RTSYork/UltrasoundRobot/robot_diagrams/robot.png

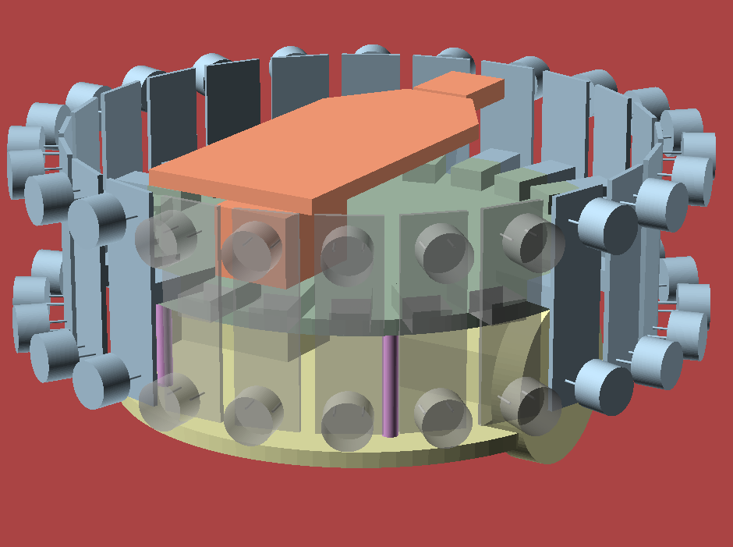
robot_diagrams/robot.png
