RTSYork/UltrasoundRobot/README.md

Ultrasonic Array for Maze Robot
----
Phil Greenland and Russell Joyce  
Department of Computer Science, University of York, UK

---

For more information, see http://rtslab.wikispaces.com/Ultrasonic+Array+for+Maze+Robot
