RTSYork/UltrasoundRobot/maze_diagrams/maze.png

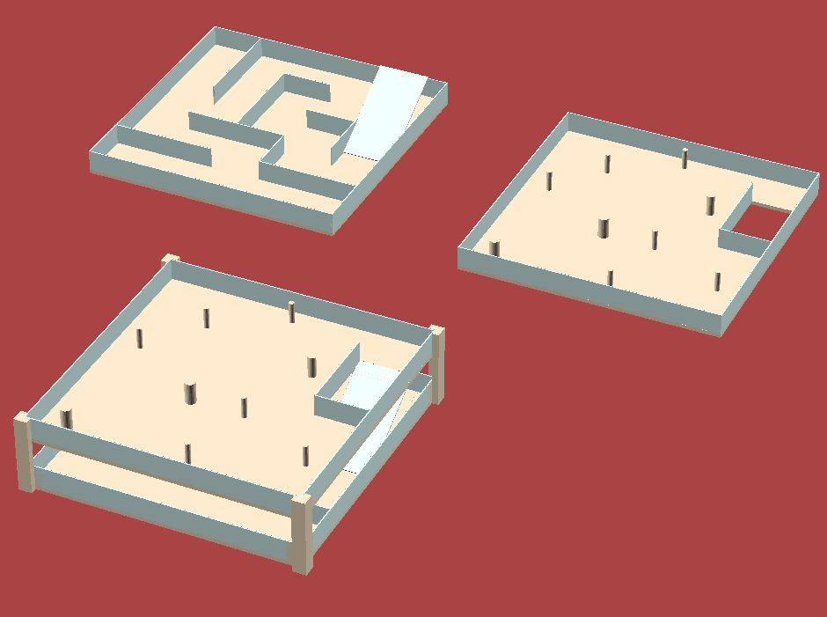
maze_diagrams/maze.png
