RTSYork/UltrasoundRobot/(list of files, cad)

Other CAD files:
cad_diagrams/placement_diagram.dwg
