RTSYork/UltrasoundRobot/ultrasound_fpga/Ultrasound/pcores/pulsegen_v1_00_a/devl/projnav/par_usage_statistics.html

Par Statistics

Total Non-vccgnd Signals=167

Total Non-vccgnd Design Pins=498

Total Non-vccgnd Conns=498

Total Non-vccgnd Timing Constrained Conns=414

Phase 1 CPU=3.7 sec

Phase 2 CPU=3.9 sec

Phase 3 CPU=4.3 sec

Phase 4 CPU=4.9 sec

Phase 5 CPU=5.1 sec

Phase 6 CPU=5.1 sec

Phase 7 CPU=5.1 sec

Phase 8 CPU=5.1 sec

Phase 9 CPU=5.1 sec

Phase 10 CPU=5.2 sec

AvgWirelenPerPin Fanout 1=13.0

AvgWirelenPerPin Fanout 2=5.5

AvgWirelenPerPin Fanout 3=14.0

AvgWirelenPerPin Fanout 4=6.8

AvgWirelenPerPin Fanout 10=3.6

AvgWirelenPerPin Fanout 50=3.3

AvgWirelenPerPin Fanout 100=0.0

AvgWirelenPerPin Fanout 500=0.0

AvgWirelenPerPin Fanout 5000=0.0

AvgWirelenPerPin Fanout 20000=0.0

AvgWirelenPerPin Fanout 50000=0.0

AvgWirelenPerPin Fanout 100000=0.0

IRR Gamma=1.0363
