RTSYork/UltrasoundRobot/eagle/ultrasound/Sensor.brd

## EAGLE design eagle/ultrasound/Sensor.brd (2013-08-06)

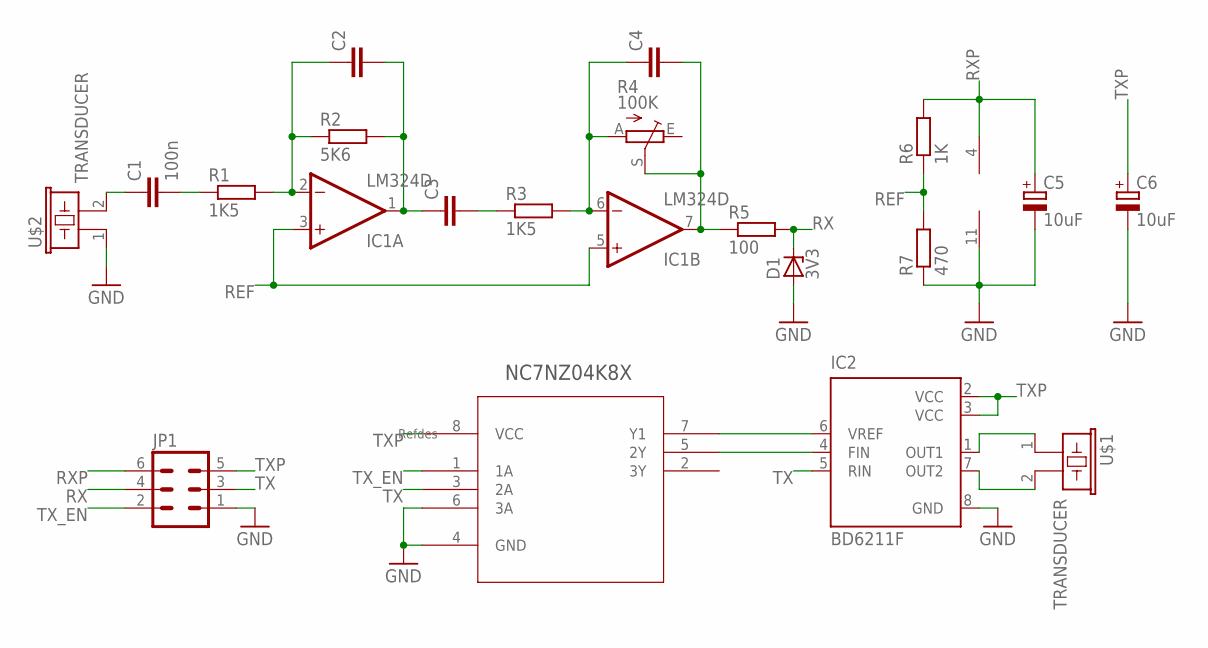
[picture p3: schematic Sensor.sch]

Parts:
C1: 100n; C0805
C2, C3, C4: C-EUC0805; C0805
C5, C6: 10uF; E2-5
D1: 3V3; ZDIO-2.5
IC1: LM324D; SO14
IC2: BD6211F; SOP8
JP1: MA03-2
R1, R3: 1K5; R0805
R2: 5K6; R0805
R4: 100K; S63P
R5: 100; R0805
R6: 1K; R0805
R7: 470; R0805
U1: NC7NZ04K8X; SOP50P310X90-8N
U$1, U$2: TRANSDUCER

Connections:
GND: C5.-, C6.-, D1.A, IC1.11 (V-), IC2.8 (GND), JP1.1, R7.1, U1.4 (GND), U1.6 (3A), U$2.1
unnamed: C2.1, IC1.2 (-IN), R1.2, R2.1
unnamed: C1.2, R1.1
unnamed: C2.2, C3.1, IC1.1 (OUT), R2.2
unnamed: C3.2, R3.1
unnamed: C4.1, IC1.6 (-IN), R3.2, R4.A
unnamed: C4.2, IC1.7 (OUT), R4.S, R5.1
unnamed: C1.1, U$2.2
unnamed: IC2.1 (OUT1), U$1.1
unnamed: IC2.7 (OUT2), U$1.2
unnamed: IC2.6 (VREF), U1.7 (Y1)
unnamed: IC2.4 (FIN), U1.5 (2Y)
REF: IC1.3 (+IN), IC1.5 (+IN), R6.1, R7.2
RX: D1.C, JP1.4, R5.2
RXP: C5.+, IC1.4 (V+), JP1.6, R6.2
TX: IC2.5 (RIN), JP1.3, U1.3 (2A)
TXP: C6.+, IC2.2 (VCC), IC2.3 (VCC), JP1.5, U1.8 (VCC)
TX_EN: JP1.2, U1.1 (1A)

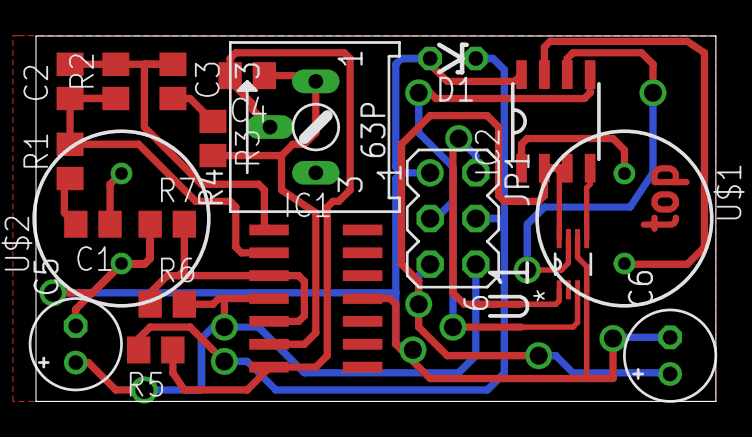
[picture p4: board Sensor.brd from above]

Board: 2 copper layers, 37.8 x 20.3 mm, 20 parts (0 on the bottom side), 18 nets.
