RTSYork/UltrasoundRobot/eagle/ultrasound/Mainboard.brd

## EAGLE design eagle/ultrasound/Mainboard.brd (2013-04-26)

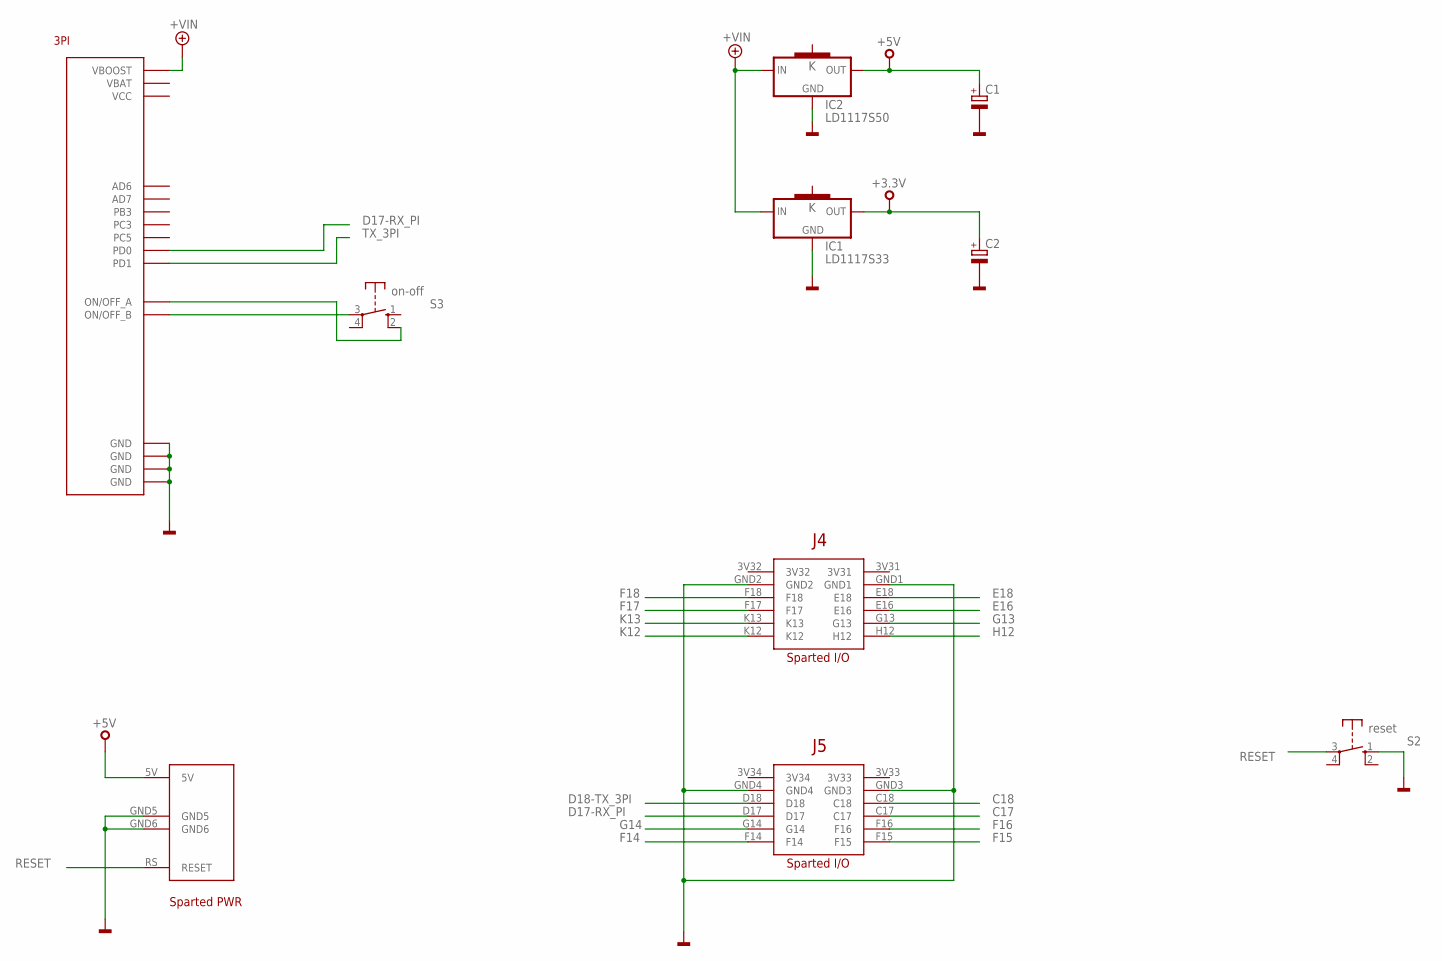
[picture p5: schematic Mainboard.sch, sheet 1]

Parts:
C1, C2: CPOL-EUE2.5-5; E2,5-5
IC1: LD1117S33; SOT223
IC2: LD1117S50; SOT223
S2: reset; DT6
S3: on-off; DT6
U$1: M3PI-NO-LCD
U$4: LX9

Connections:
+3,3V: C2.+, IC1.2 (OUT)
+5V: C1.+, IC2.2 (OUT), U$4.5V; also elsewhere on the board
+VIN: IC1.3 (IN), IC2.3 (IN), U$1.VBOOST
C17: U$4.C17; also elsewhere on the board
C18: U$4.C18; also elsewhere on the board
D17-RX_PI: U$1.PD0, U$4.D17
D18-TX_3PI: U$4.D18; also elsewhere on the board
E16: U$4.E16; also elsewhere on the board
E18: U$4.E18; also elsewhere on the board
F14: U$4.F14; also elsewhere on the board
F15: U$4.F15; also elsewhere on the board
F16: U$4.F16; also elsewhere on the board
F17: U$4.F17; also elsewhere on the board
F18: U$4.F18; also elsewhere on the board
G13: U$4.G13; also elsewhere on the board
G14: U$4.G14; also elsewhere on the board
GND: C1.-, C2.-, IC1.1 (GND), IC2.1 (GND), S2.1 (S), U$1.GND@1 (GND), U$1.GND@2 (GND), U$1.GND@3 (GND), U$1.GND@4 (GND), U$4.GND1, U$4.GND2, U$4.GND3, U$4.GND4, U$4.GND5, U$4.GND6; also elsewhere on the board
H12: U$4.H12; also elsewhere on the board
K12: U$4.K12; also elsewhere on the board
K13: U$4.K13; also elsewhere on the board
unnamed: S3.3, U$1.ON/OFF_B
unnamed: S3.2 (S), U$1.ON/OFF_A
RESET: S2.3, U$4.RS (RESET)
TX_3PI: U$1.PD1; also elsewhere on the board

Notes on the sheet:
Sparted I/O
Sparted PWR

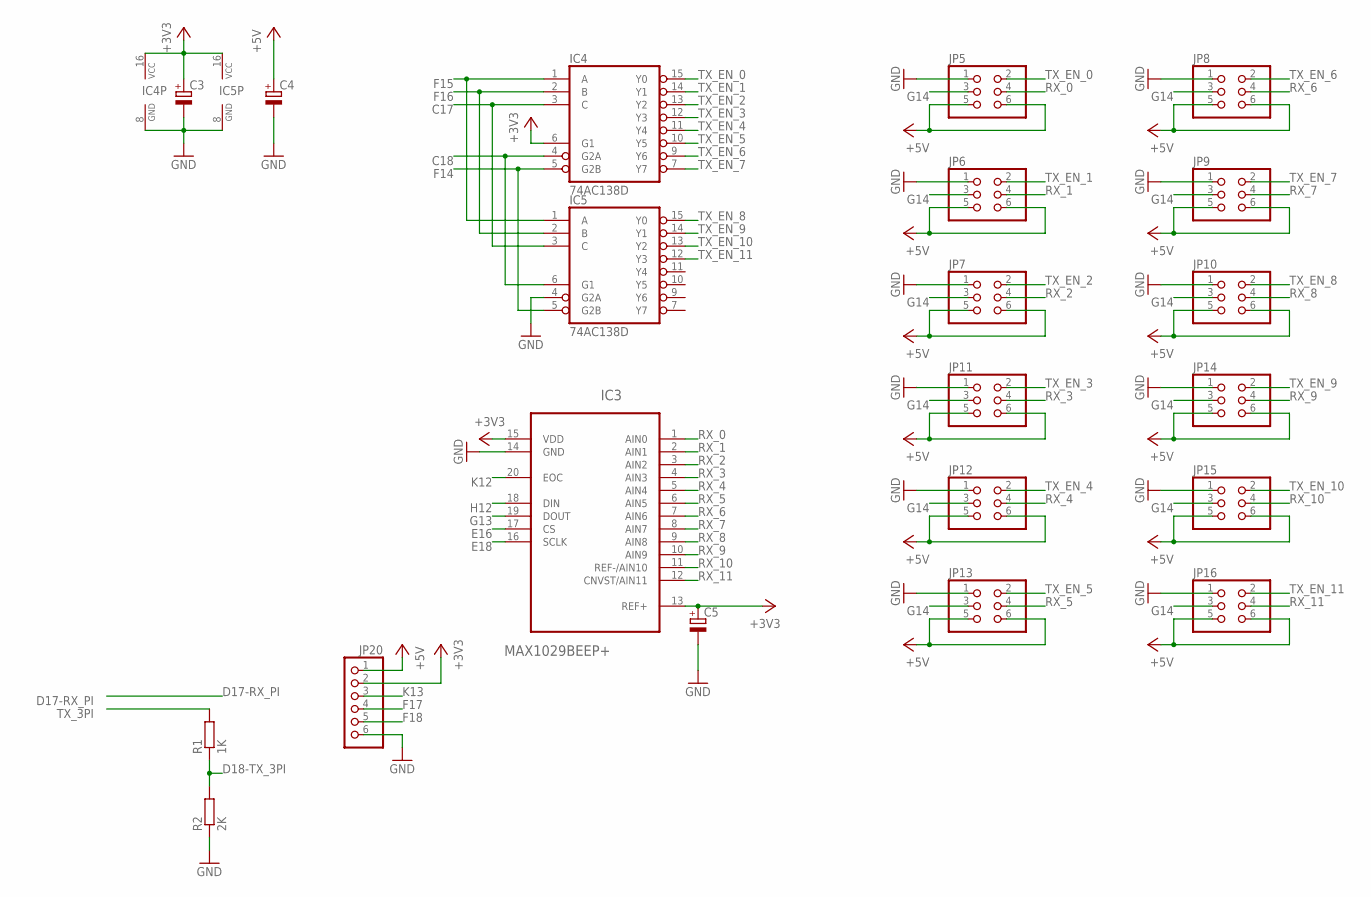
[picture p6: schematic Mainboard.sch, sheet 2]

Parts:
C3, C4, C5: CPOL-EUE2-5; E2-5
IC3: MAX1029BEEP+; SOP64P600X165-20N
IC4, IC5: 74AC138D; SO16
JP5, JP9: PINHD-2X3; 2X03
JP6, JP7, JP8, JP10, JP11, JP12, JP13, JP14, JP15, JP16: PINHD-2X3/90; 2X03/90
JP20: PINHD-1X6; 1X06
R1: 1K; R0805
R2: 2K; R0805

Connections:
+3V3: C3.+, C5.+, IC3.13 (REF+), IC3.15 (VDD), IC4.6 (G1), IC4.16 (VCC), IC5.16 (VCC), JP20.2
+5V: C4.+, JP5.5, JP5.6, JP6.5, JP6.6, JP7.5, JP7.6, JP8.5, JP8.6, JP9.5, JP9.6, JP10.5, JP10.6, JP11.5, JP11.6, JP12.5, JP12.6, JP13.5, JP13.6, JP14.5, JP14.6, JP15.5, JP15.6, JP16.5, JP16.6, JP20.1; also elsewhere on the board
C17: IC4.3 (C), IC5.3 (C); also elsewhere on the board
C18: IC4.4 (G2A), IC5.6 (G1); also elsewhere on the board
D18-TX_3PI: R1.1, R2.2; also elsewhere on the board
E16: IC3.17 (CS); also elsewhere on the board
E18: IC3.16 (SCLK); also elsewhere on the board
F14: IC4.5 (G2B), IC5.5 (G2B); also elsewhere on the board
F15: IC4.1 (A), IC5.1 (A); also elsewhere on the board
F16: IC4.2 (B), IC5.2 (B); also elsewhere on the board
F17: JP20.4; also elsewhere on the board
F18: JP20.5; also elsewhere on the board
G13: IC3.19 (DOUT); also elsewhere on the board
G14: JP5.3, JP6.3, JP7.3, JP8.3, JP9.3, JP10.3, JP11.3, JP12.3, JP13.3, JP14.3, JP15.3, JP16.3; also elsewhere on the board
GND: C3.-, C4.-, C5.-, IC3.14 (GND), IC4.8 (GND), IC5.4 (G2A), IC5.8 (GND), JP5.1, JP6.1, JP7.1, JP8.1, JP9.1, JP10.1, JP11.1, JP12.1, JP13.1, JP14.1, JP15.1, JP16.1, JP20.6, R2.1; also elsewhere on the board
H12: IC3.18 (DIN); also elsewhere on the board
K12: IC3.20 (EOC); also elsewhere on the board
K13: JP20.3; also elsewhere on the board
RX_0: IC3.1 (AIN0), JP5.4
RX_1: IC3.2 (AIN1), JP6.4
RX_2: IC3.3 (AIN2), JP7.4
RX_3: IC3.4 (AIN3), JP11.4
RX_4: IC3.5 (AIN4), JP12.4
RX_5: IC3.6 (AIN5), JP13.4
RX_6: IC3.7 (AIN6), JP8.4
RX_7: IC3.8 (AIN7), JP9.4
RX_8: IC3.9 (AIN8), JP10.4
RX_9: IC3.10 (AIN9), JP14.4
RX_10: IC3.11 (REF-/AIN10), JP15.4
RX_11: IC3.12 (CNVST/AIN11), JP16.4
TX_3PI: R1.2; also elsewhere on the board
TX_EN_0: IC4.15 (Y0), JP5.2
TX_EN_1: IC4.14 (Y1), JP6.2
TX_EN_2: IC4.13 (Y2), JP7.2
TX_EN_3: IC4.12 (Y3), JP11.2
TX_EN_4: IC4.11 (Y4), JP12.2
TX_EN_5: IC4.10 (Y5), JP13.2
TX_EN_6: IC4.9 (Y6), JP8.2
TX_EN_7: IC4.7 (Y7), JP9.2
TX_EN_8: IC5.15 (Y0), JP10.2
TX_EN_9: IC5.14 (Y1), JP14.2
TX_EN_10: IC5.13 (Y2), JP15.2
TX_EN_11: IC5.12 (Y3), JP16.2

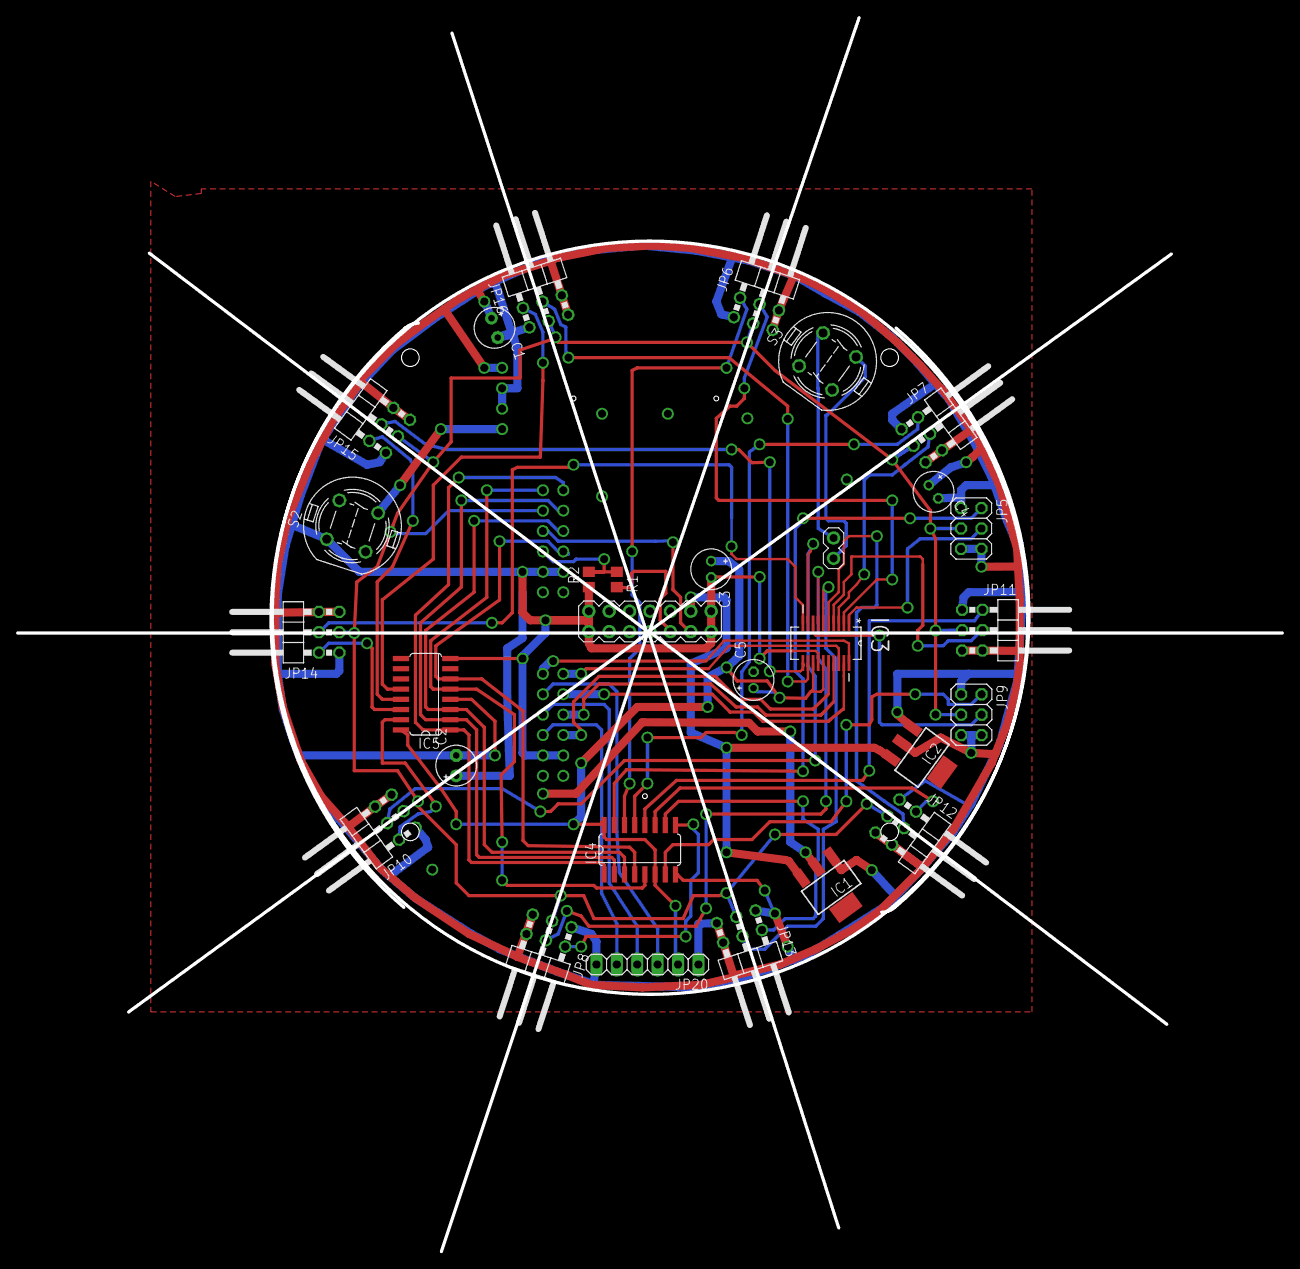
[picture p7: board eagle/ultrasound/Mainboard.brd from above]

Board: 2 copper layers, 157.5 x 153.7 mm, 29 parts (1 on the bottom side), 49 nets.
