RTSYork/UltrasoundRobot/eagle/fpga-3pi/FPGA-m3pi.brd

## EAGLE design eagle/fpga-3pi/FPGA-m3pi.brd (2013-04-26)

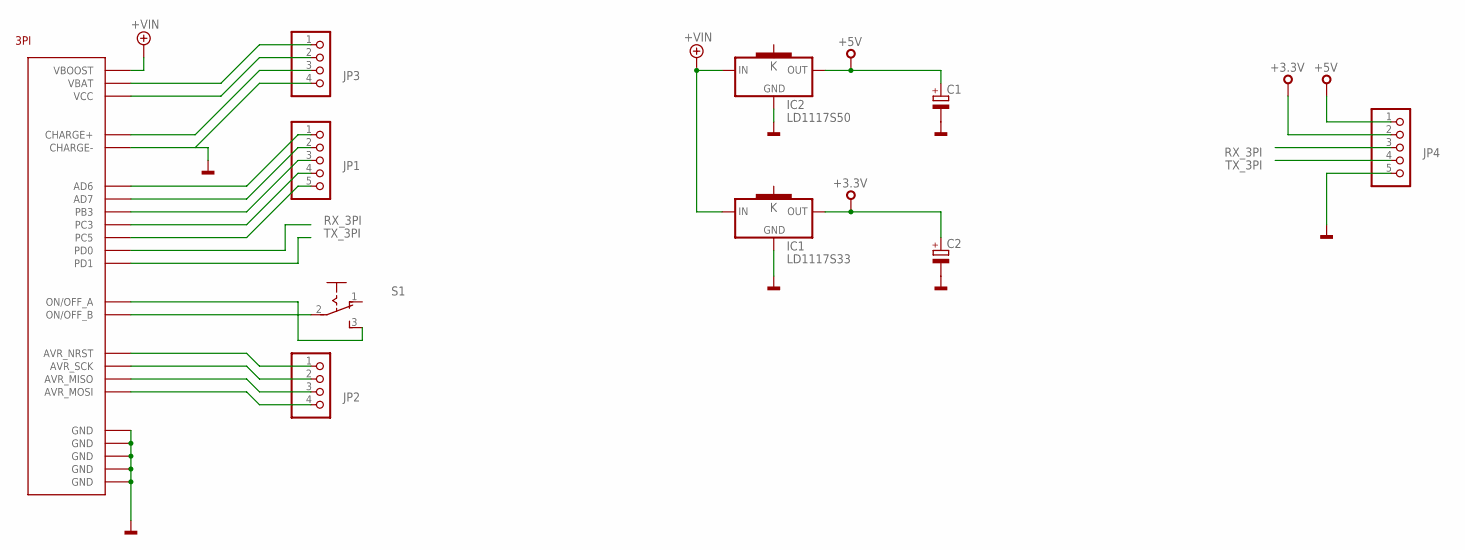
[picture p8: schematic FPGA-m3pi.sch]

Parts:
C1, C2: CPOL-EUE2.5-5; E2,5-5
IC1: LD1117S33; SOT223
IC2: LD1117S50; SOT223
JP1, JP4: PINHD-1X5; 1X05
JP2, JP3: PINHD-1X4; 1X04
S1: M251
U$1: MBED-M3PI_3PI

Connections:
+3,3V: C2.+, IC1.2 (OUT), JP4.2
+5V: C1.+, IC2.2 (OUT), JP4.1
+VIN: IC1.3 (IN), IC2.3 (IN), U$1.VBOOST
GND: C1.-, C2.-, IC1.1 (GND), IC2.1 (GND), JP3.4, JP4.5, U$1.CHARGE-, U$1.GND@1 (GND), U$1.GND@2 (GND), U$1.GND@3 (GND), U$1.GND@4 (GND), U$1.GND@5 (GND)
unnamed: JP1.1, U$1.AD6
unnamed: JP1.2, U$1.AD7
unnamed: S1.2, U$1.ON/OFF_B
unnamed: S1.3 (S), U$1.ON/OFF_A
unnamed: JP1.3, U$1.PB3
unnamed: JP1.4, U$1.PC3
unnamed: JP1.5, U$1.PC5
unnamed: JP2.1, U$1.AVR_NRST
unnamed: JP2.2, U$1.AVR_SCK
unnamed: JP2.3, U$1.AVR_MISO
unnamed: JP2.4, U$1.AVR_MOSI
unnamed: JP3.3, U$1.CHARGE+
unnamed: JP3.2, U$1.VCC
unnamed: JP3.1, U$1.VBAT
RX_3PI: JP4.3, U$1.PD0
TX_3PI: JP4.4, U$1.PD1

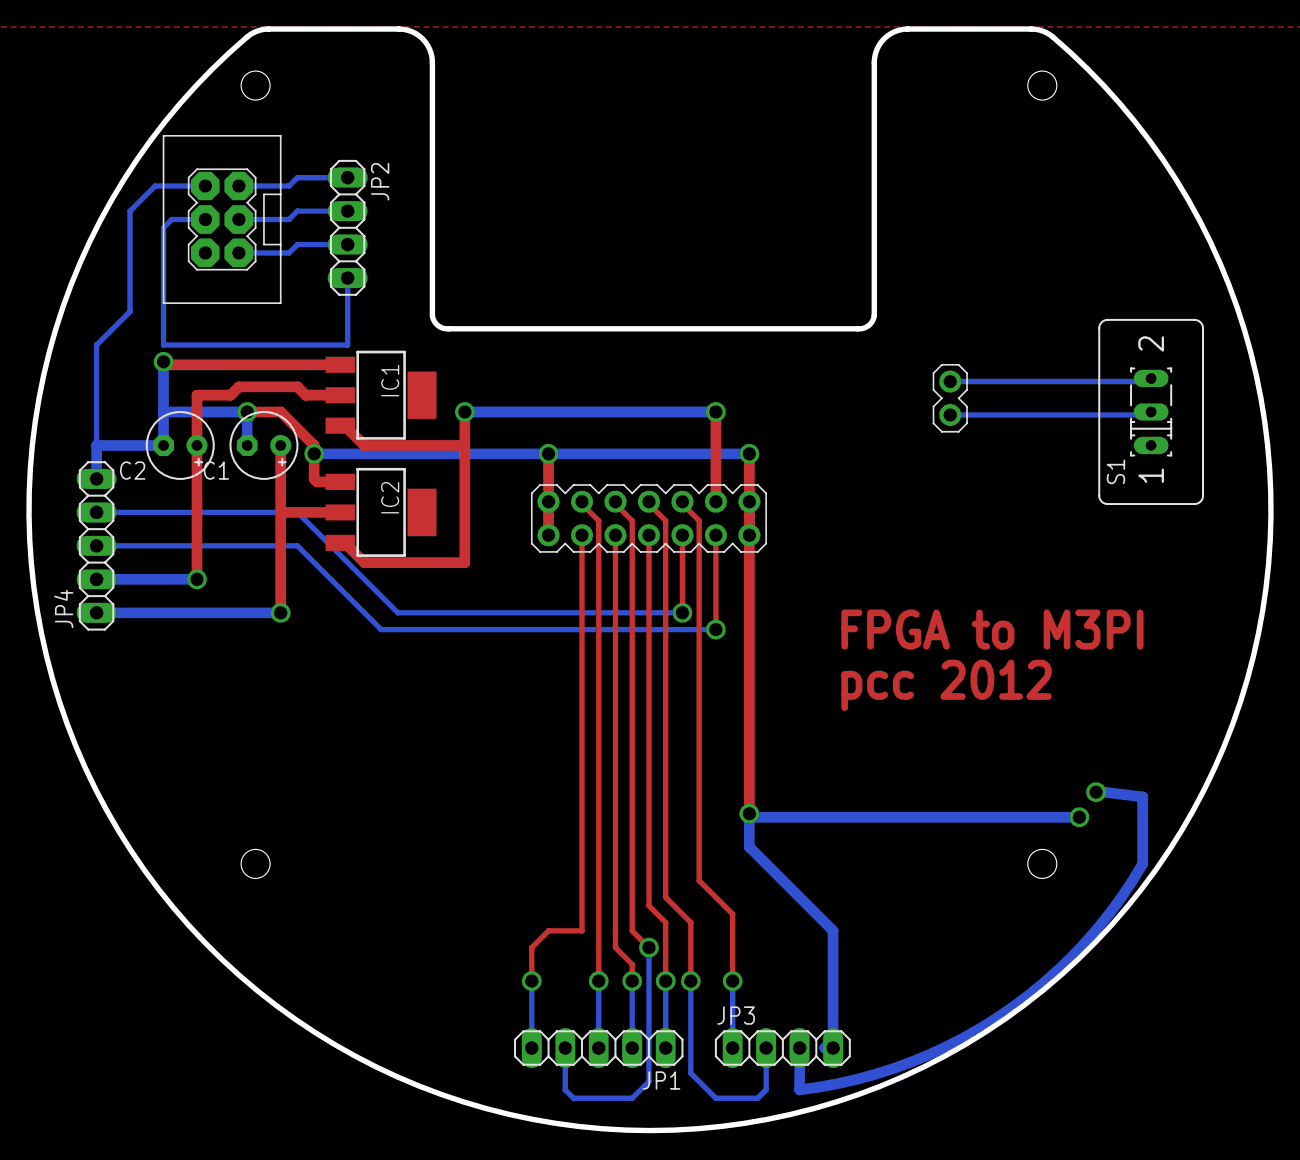
[picture p9: board FPGA-m3pi.brd from above]

Board: 2 copper layers, 94.2 x 83.6 mm, 10 parts (0 on the bottom side), 20 nets.
