RTSYork/UltrasoundRobot/eagle/prototype/Mainboard.brd

## EAGLE design eagle/prototype/Mainboard.brd (2013-04-26)

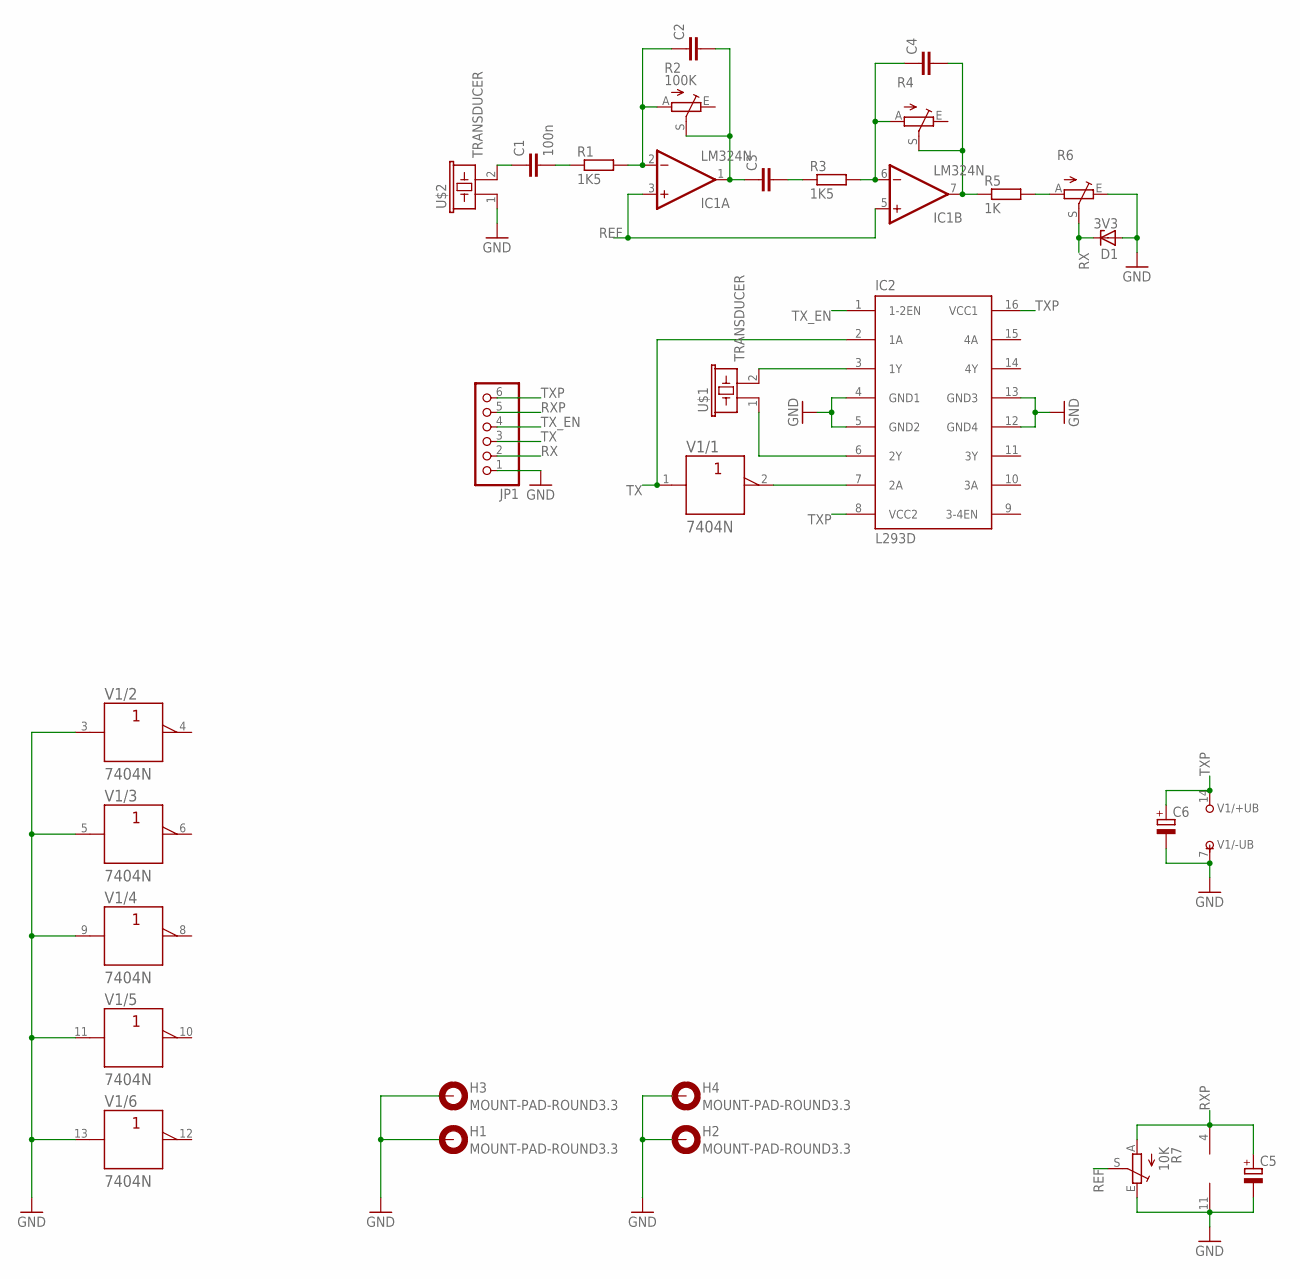
[picture p10: schematic Mainboard.sch]

Parts:
C1: 100n; C025-025X050
C2, C3, C4: C-EU025-025X050; C025-025X050
C5, C6: CPOL-EUE2-5; E2-5
D1: 3V3; ZDIO-2.5
H1, H2, H3, H4: MOUNT-PAD-ROUND3.3; 3,3-PAD
IC1: LM324N; DIL14
IC2: L293D; DIL16
JP1: PINHD-1X6; 1X06
R1, R3: 1K5; 0207/2V
R2: 100K; S63P
R4, R6: TRIM_EU-S63P; S63P
R5: 1K; 0207/2V
R7: 10K; S63P
U$1, U$2: TRANSDUCER
V1: 7404N; DIL14

Connections:
GND: C5.-, C6.-, D1.A, H1.B3,3, H2.B3,3, H3.B3,3, H4.B3,3, IC1.11 (V-), IC2.4 (GND1), IC2.5 (GND2), IC2.12 (GND4), IC2.13 (GND3), JP1.1, R6.E, R7.E, U$2.1, V1.3 (A), V1.5 (A), V1.7 (-UB), V1.9 (A), V1.11 (A), V1.13 (A)
unnamed: C2.1, IC1.2 (-IN), R1.2, R2.A
unnamed: C1.2, R1.1
unnamed: C2.2, C3.1, IC1.1 (OUT), R2.S
unnamed: R5.2, R6.A
unnamed: C3.2, R3.1
unnamed: C4.1, IC1.6 (-IN), R3.2, R4.A
unnamed: C4.2, IC1.7 (OUT), R4.S, R5.1
unnamed: IC2.7 (2A), V1.2 (Y)
unnamed: C1.1, U$2.2
unnamed: IC2.3 (1Y), U$1.2
unnamed: IC2.6 (2Y), U$1.1
REF: IC1.3 (+IN), IC1.5 (+IN), R7.S
RX: D1.C, JP1.2, R6.S
RXP: C5.+, IC1.4 (V+), JP1.5, R7.A
TX: IC2.2 (1A), JP1.3, V1.1 (A)
TXP: C6.+, IC2.8 (VCC2), IC2.16 (VCC1), JP1.6, V1.14 (+UB)
TX_EN: IC2.1 (1-2EN), JP1.4

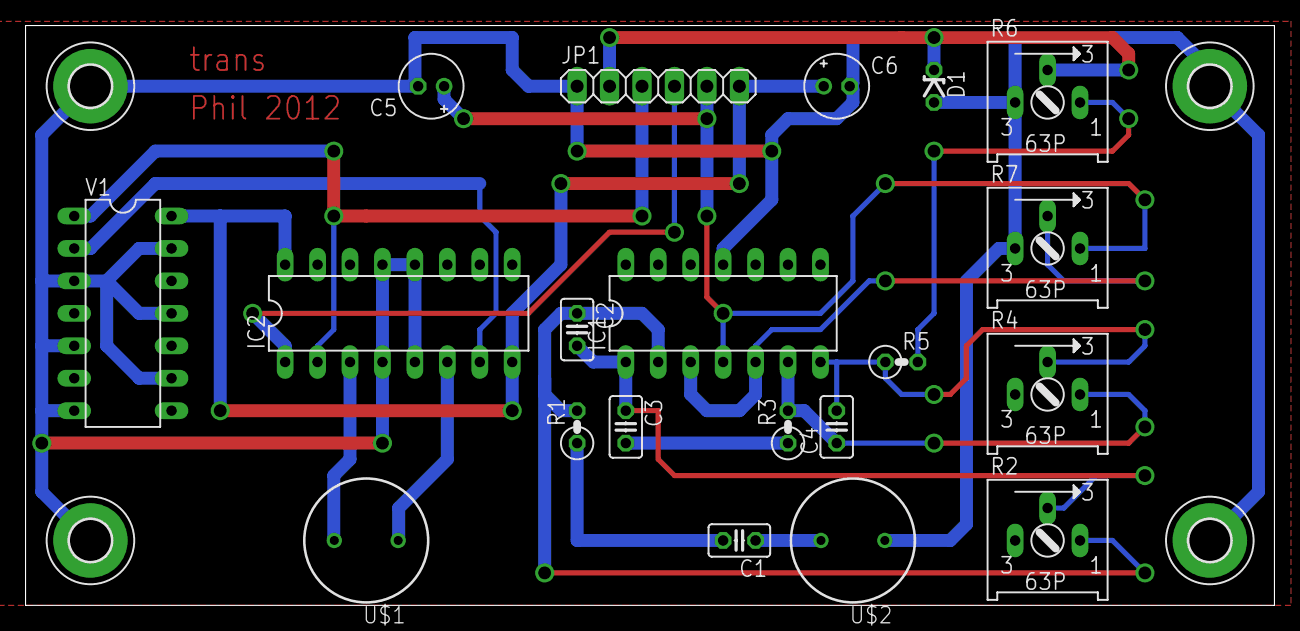
[picture p11: board eagle/prototype/Mainboard.brd from above]

Board: 2 copper layers, 97.8 x 45.4 mm, 24 parts (0 on the bottom side), 18 nets.
