RTSYork/UltrasoundRobot/ultrasound_fpga/workspace/ultrasound/src/usarray.h

#ifndef USARRAY_H_
#define USARRAY_H_

#include "xil_types.h"

#define US_SENSOR_COUNT 10 // Number of sensors installed on platform
#define US_SENSOR_MAP {9, 10, 11, 1, 2, 3, 4, 5, 6, 8} //Map sensor positions to sensor addresses
#define US_SAMPLE_RATE 80000 // Hz
#define US_RX_COUNT 200 // Number of waveform samples to take at US_SAMPLE_RATE in a single ranging operation
#define US_TX_COUNT 8 // Cycles of 40Khz ultrasound to transmit

#define USADCPrecision 10 // Bits
#define USADCReference 330 // Volts - expressed in hundredths

#define TRIGGER_NEAR_FAR_CHANGE 900 //  Time at which far trigger is used instead of near trigger
#define TRIGGER_BASE 160 // Default trigger voltage for distance detection (V*100)
#define TRIGGER_OFFSET_NEAR 41 // Default amount near trigger is away from base value
#define TRIGGER_OFFSET_FAR 11 // Default amount far trigger is away from base value

// Sensor locations
enum SENSOR_POSITION {
	SENSOR_FRONT_RIGHT = 8,
	SENSOR_RIGHT_FRONT = 9,
	SENSOR_RIGHT_MID   = 0,
	SENSOR_RIGHT_REAR  = 1,
	SENSOR_REAR_RIGHT  = 2,
	SENSOR_REAR_LEFT   = 3,
	SENSOR_LEFT_REAR   = 4,
	SENSOR_LEFT_MID    = 5,
	SENSOR_LEFT_FRONT  = 6,
	SENSOR_FRONT_LEFT  = 7
};

extern unsigned short usWaveformData[US_SENSOR_COUNT][US_RX_COUNT]; // Provide external access to sample results
extern signed short usRangeReadings[US_SENSOR_COUNT]; // Provide external access to range readings

int init_usarray();

void usarray_set_sensor(unsigned char newSensor);
unsigned char usarray_get_sensor();

void usarray_set_triggers(unsigned short changever, unsigned short nearLower, unsigned short nearUpper, unsigned short farLower, unsigned short farUpper);

short usarray_get_temperature();

void usarray_measure_temp();
void usarray_scan(u8 sensors[], u8 numSensors);
void usarray_update_ranges(u8 sensors[], u8 numSensors);

u16 usarray_distance(u8 sensor);
u8 usarray_detect_obstacle(u8 sensor, u16 distance);

#endif /* USARRAY_H_ */
