RTSYork/UltrasoundRobot/(commit log)

2013-04-19 Added 3D printed wheels and encoder template
    [3piwheelv1.scad, 3piwheelv2.scad, hole_test.scad]
2013-04-19 Added CAD diagrams
    [placement_diagram.dwg]
2013-04-19 Added maze diagrams
    [Maze.scad]
2013-04-19 Added ultrasound code for arduino and mbed, with processing code
2013-04-26 Added eagle diagrams
    [Darlington TX.sch, FPGA-m3pi.brd, FPGA-m3pi.sch, HBridge TX.sch, Mainboard.brd, Mainboard.sch, Sensor.brd, Sensor.sch]
2013-04-27 Renamed report eagle schematics to match figures.
    [darlington_ustx.sch, hbridge_ustx.sch]
2013-04-28 Continued design and implementation adding receiver amp and filters.
    [invert_amp_filters.sch, opamp_usrx.sch]
2013-04-29 Continued design and implementation.
    [invert_amp_filters.sch, opamp_usrx.sch]
2013-04-29 Removed pot from blueboard schematic.
    [opamp_usrx.sch]
2013-05-01 Continued design and implementation, completing all range finder diagrams.
    [Sensor.brd, Sensor.sch, mainboard.sch]
2013-05-02 Updated component values on daughter board schematic to match actual board.
    [Sensor.brd, Sensor.sch]
2013-05-02 Added positioning system to design and implementation.
    [pos_sys.sch]
2013-05-04 Added 3D robot diagram :-).
    [Robot.scad]
2013-05-04 Increased daughter board count to 28 and decreased width.
    [Robot.scad]
2013-05-04 Added 3D robot diagram to report.
    [Robot.scad]
2013-05-05 Compacted diagrams and headings. Changed word count format. Updated report page plan. Remoed mobile platform from design. Added placeholder software flow diagrams.
    [invert_amp_filters.sch, opamp_usrx.sch]
2013-05-09 Added temperature compensation to processing app, fixed trigger levels.
2013-05-18 Tweaked various bits of design and implementation. Reduced font size on all diagrams and adjusted diagrams accordingly.
    [darlington_ustx.sch]
2013-05-20 Bug fixes and tweaks to 3pi software.
    [ultrasound_3pi.ino]
2013-05-20 Bug fixes and additional features for ultrasound_fpga.
    [uart.c, uart.h, ultrasound.c, usarray.c, usarray.h]
2013-05-20 Modified mbed and arduino apps to supply new data format.
2013-08-06 Updated Distance and Waveform programs Now use new data format from MicroBlaze, fixes bugs
    [distance.pde, waveform.pde]
2013-08-06 Updated sensor board resistor value in Eagle files
    [Sensor.brd, Sensor.sch]
2013-08-06 Changed USB UART speed to 57600bps
2013-08-06 Made 'map' and 'par' synthesis steps use 2 threads
2013-08-08 Removed extra range offset for sensors 0 and 5 Hardware has been changed so they are now the same as all other sensors
2013-08-08 Changed how sensors are selected for sampling Now allows for an array of sensors to be specified
2013-08-08 Added obstacle detection function Returns if an item is detected within Xmm of a sensor
2013-08-08 Added constants for robot motor direction
2013-08-08 Reduced the number of US samples from 400 to 200 Quicker to sample and still sufficient for small distances
2013-08-09 Added function to get range from US sensor
2013-08-09 Added constants for US sensor positions
2013-08-09 Added state machine for robot driving control Robot avoids walls, turns in the correct direction at a junction
    [ultrasound.c, ultrasound.h]
2013-08-12 Added UART for Bluetooth, removed SPI+GPIO cores SPI Flash and Dip Switch cores not needed, changed MB settings for space
2013-08-12 Added Bluetooth UART debug messages Prints the state of the robot movement over Bluetooth UART
